juandpenan/SistemasEmbebidos/README.md

# Control de nivel de un tanque 

Trabajo final de la asignatura sistemas embebidos del master de informatíca industrial y robotíca:

<p align="center">
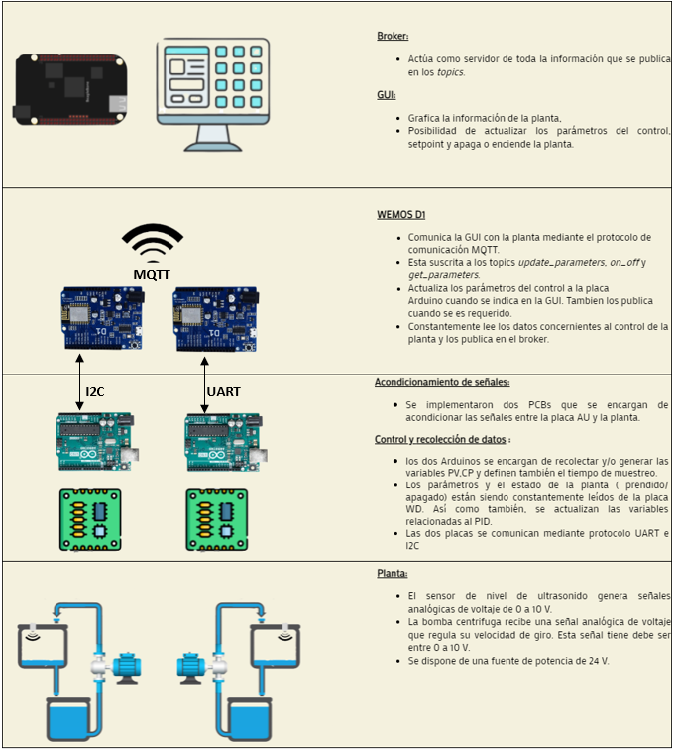
[picture p1: ss/Capture.PNG]
  
</p>
