juandpenan/SistemasEmbebidos/src/Interfaz gráfica/off2.gif

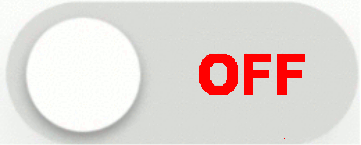
src/Interfaz gráfica/off2.gif
